Rich5252/Arduino_ESP32_AD9851_ssb_signal_generator/Design data/SSB_Exciter_G4AHN.png

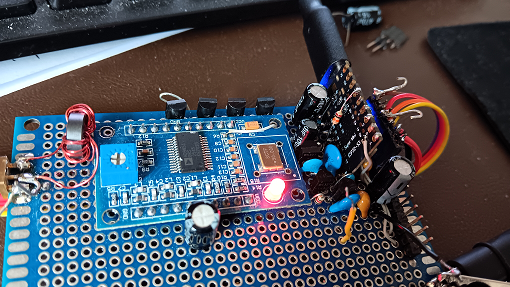
Design data/SSB_Exciter_G4AHN.png
