Rich5252/Arduino_ESP32_AD9851_ssb_signal_generator/Design data/timing_architecture.html

ESP32-S3 · Polar EER SSB Exciter · Firmware Reference

# How the two cores divide real-time work

gptimer drives a 64 kHz fast-tick interrupt on Core 1 that wakes dsp_task on Core 0 for every sample. Only one wake in four does the real DSP/RF work — that's the 16 kHz sample rate, Fs. Everything else on Core 1 (the ADC, loop(), serial, diagnostics) exists to stay out of that interrupt's way.

Every gray arrow is FreeRTOS/driver plumbing; the one in coral is the single hop that actually crosses cores — vTaskNotifyGiveFromISR(), fired from Core 1's gptimer ISR 64,000 times a second to wake dsp_task on Core 0. Everything else Core 1 does (ADC, serial, diagnostics) exists to avoid delaying that one interrupt. The two green badges mark the fixes confirmed on real hardware this session.

## Key rates & periods

Signal / event | Rate | Period | Note
C1→C0gptimer fast tick | 64 kHz | 15.625 µs | wakes dsp_task every firing; only 1 of 4 does full work
C0DSP full tick (Fs) | 16 kHz | 62.5 µs | SAMPLE_RATE_HZ — the real sample rate of the signal chain
C1ADC conversion | 80 kHz | 12.5 µs | free-running always, regardless of audio source mode
C1ADC callback (conv_done) | 5 kHz | 200 µs | 16-sample frames · ADC_CONT_FRAME_SAMPLES
C1loop() cycle | ~100 Hz | ~10 ms | delay(10)-dominated — ~98% of the cycle
C1diagnostics status line | ~22 Hz | 45 ms | envelope / freq_dev / dac_code, one line
C1diagnostics full block | ~1 Hz | ~1000 ms | [timing]/[adc]/[dsp]/[core1] — now per-line TX-guarded

ESP32-S3 · ssb_mic_test firmware · timing checkpoint as of this session cross-core hop confirmed fix
