Rich5252/Arduino_ESP32_AD9851_ssb_signal_generator/Design data/adc_filter_response_2026-09-29.png

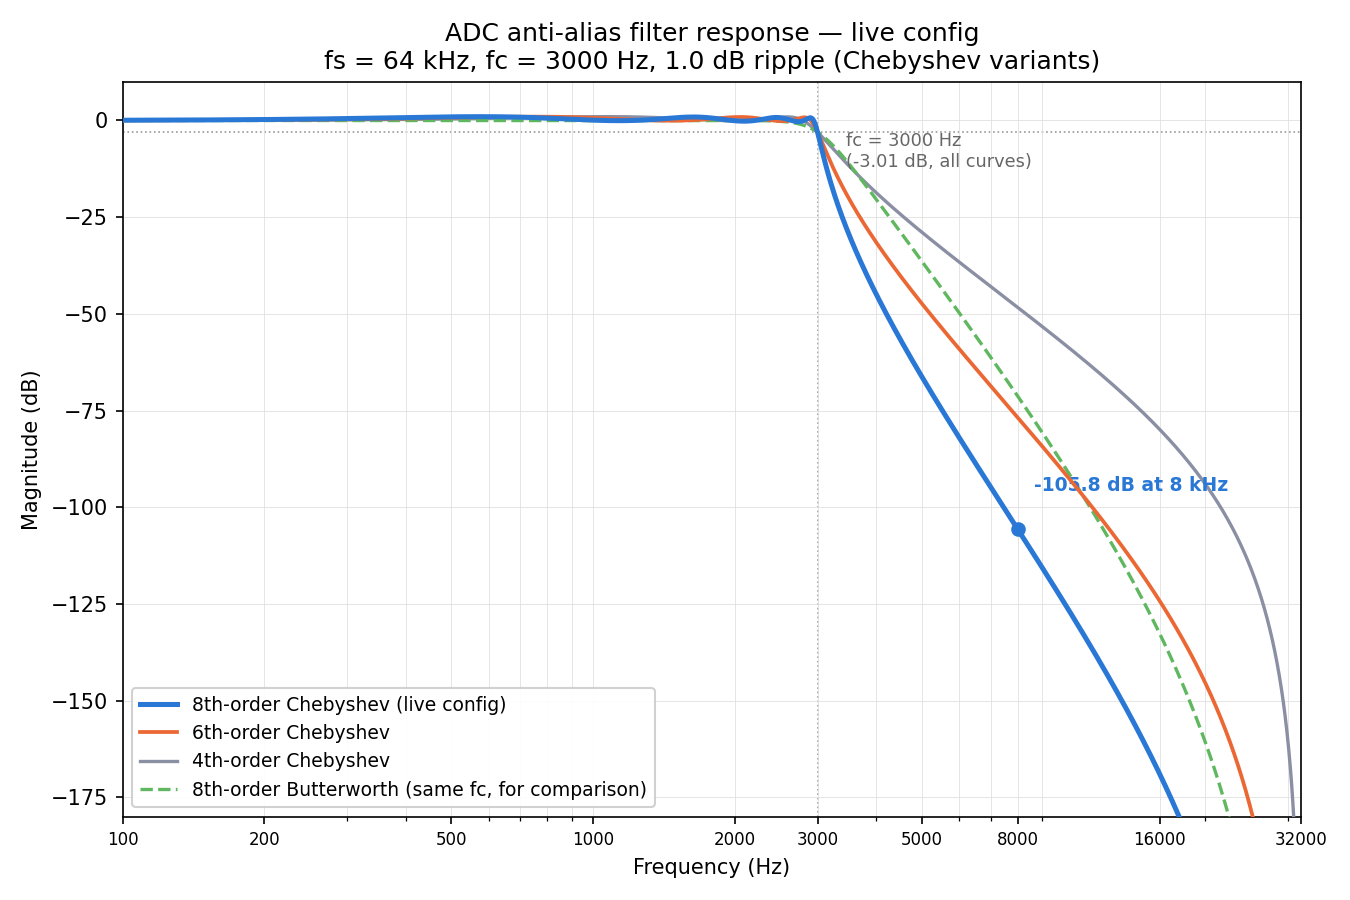
Design data/adc_filter_response_2026-09-29.png
