Rich5252/Arduino_ESP32_AD9851_ssb_signal_generator/Design data/PWM reconstruction Filter Circuit.png

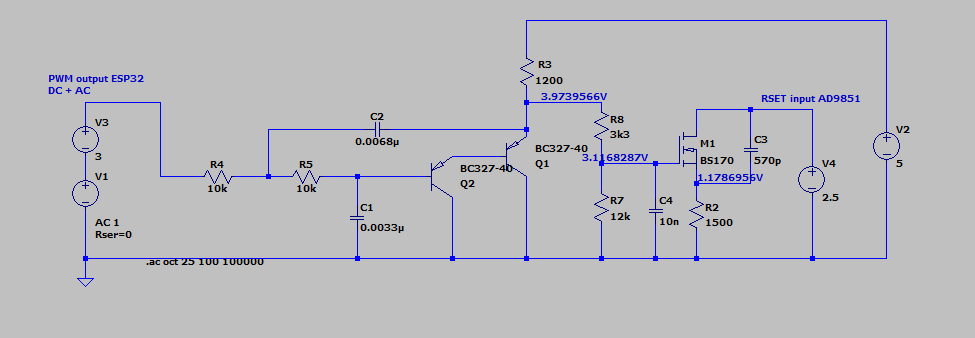
Design data/PWM reconstruction Filter Circuit.png
