Rich5252/Arduino_ESP32_AD9851_ssb_signal_generator/ssb_mic_test.ino

/**
 * DAC version 1
 * ssb_mic_test.ino
 *
 * Arduino-IDE test bed for the SSB mic/DSP pipeline, refactored from the
 * ESP-IDF main.c worked example. AD9851/DDS code is stubbed out entirely
 * (behind AD9851_ATTACHED) - this sketch exercises: mic ADC -> ssb_dsp ->
 * {freq_dev_hz, envelope} -> MCP4725 DAC output (RSET modulation), on two
 * FreeRTOS tasks:
 *
 *   dsp_task  (Core 0, high priority) - timer-notified, does the ADC read,
 *             DSP, and (when attached) the AD9851 SPI write. Never blocks
 *             on the DAC - it drops the computed envelope into a 1-deep
 *             "latest value wins" queue and moves straight on. (Briefly
 *             tried on Core 1 instead during the Fs jitter hunt - see
 *             setup()'s "TRIED, REVERTED" note - real hardware starved
 *             Serial entirely, reverted.)
 *   dac_task  (Core 1, lower priority) - blocks waiting for a new envelope
 *             value, then does the MCP4725 I2C fast-write (~70us at
 *             400kHz - far too slow to share a task with the phase-
 *             critical AD9851 update without risking it). At the current
 *             SAMPLE_RATE_HZ this comfortably fits within one sample
 *             period. If you ever raise the sample rate materially,
 *             revisit this - the I2C write doesn't scale down with a
 *             faster sample clock, and an SPI DAC (e.g. MCP4921) would be
 *             the fix at that point.
 *
 * Why a DAC instead of PWM+RC filter, MCP4725 pinout, ADC design history,
 * the group-delay-equalizer derivation, etc: see the module headers below
 * (envelope_output.h, adc_capture.h, envelope_gdeq.h, relative_delay.h) -
 * this file used to carry all of that inline, but at ~1900 lines with
 * everything in one place it was getting hard to navigate. It's now split
 * into one module per concern, each owning its own state behind a small
 * function-based interface (never raw `extern`-shared globals) so nothing
 * outside a module can get at its internals except through that
 * interface:
 *
 *   config.h           - shared compile-time constants (#defines only)
 *   settings.h          - audio_source_t, PersistentSettings, presets (unchanged)
 *   dsp_state.h/.cpp    - the ssb_dsp handle, sideband, audio source, gain cache
 *   adc_capture.h/.cpp  - adc_continuous DMA setup, ISR FIFO, biquad LPF
 *   test_signals.h/.cpp - two-tone/single-tone/ENVSTEP/FMTEST/AMTEST generators
 *   envelope_gdeq.h/.cpp- the envelope-path group-delay all-pass equalizer
 *   relative_delay.h/.cpp - phase/envelope fractional relative-timing line
 *   carrier_output.h/.cpp - AD9851 init + per-tick frequency update
 *   envelope_output.h/.cpp - PWM (RSET) + MCP4725 DAC + dac_task
 *   diagnostics.h/.cpp  - dsp_task timing stats + periodic status prints
 *   serial_commands.h/.cpp - the single-character serial command handler
 *
 * What's left here is genuinely top-level orchestration only: the sample
 * timer ISR, dsp_task's per-tick call sequence, setup(), and loop().
 * Nothing about the real-time behavior changed in this split - every
 * function that used to run inline in dsp_task is now a small IRAM_ATTR
 * function in its owning module, called in exactly the same order.
 *
 * NOT COMPILER-VERIFIED: this refactor was done by careful manual review
 * (no ESP32/Arduino toolchain available in the environment it was written
 * in) - run an Arduino IDE compile pass before flashing to hardware.
 *
 * Completely standalone - doesn't touch or depend on TXlink at all yet.
 * Drop this .ino into a sketch folder of the same name, next to all the
 * other .c/.cpp/.h files listed above.
 *
 * WIRING:
 *  - Mic preamp -> GPIO6 (ADC1 channel 5 on ESP32-S3).
 *  - MCP4725 SDA -> MCP4725_SDA_GPIO, SCL -> MCP4725_SCL_GPIO. Needs
 *    external ~4.7k pull-ups on both lines for reliable 400kHz operation -
 *    the ESP32's internal pull-ups are too weak on their own.
 *  - MCP4725 I2C address 0x61 (A0 pin tied high).
 *  - MCP4725 VOUT feeds your RSET modulation circuit.
 *  - PWM comparison output (RSET_MOD_LEDC_GPIO) -> RC filter -> scope,
 *    for side-by-side comparison against the DAC output only.
 *
 * What to check once the preamp and DAC are wired up:
 *  - Serial monitor (921600): throttled envelope/freq-dev/DAC-code
 *    summary, printed from loop() on Core 1 at low priority so it can
 *    never perturb either real-time task.
 *  - Scope on the MCP4725's VOUT pin: should track your voice envelope
 *    directly, no switching ripple to look for at all.
 *  - TWOTONE_TEST_MODE (config.h) bypasses the mic with a synthesized
 *    signal - a zero-hardware smoke test of the DSP chain.
 *
 * When the AD9851 board arrives: flip AD9851_ATTACHED to 1 (config.h) and
 * fill in ad9851_init()/ad9851_set_frequency() calls - the DSP/task/
 * timer/DAC structure here doesn't need to change either way.
 *
 * AUDIO_FX_ENABLED (config.h) turns on an optional pre-Hilbert
 * conditioning stage inside ssb_dsp itself (HPF + presence peak +
 * compressor, see ssb_dsp.h). Runs on plain mult/add per sample - no
 * measurable timing impact expected, but re-check the TIMING_DEBUG_GPIO
 * scope trace after enabling to confirm rather than assume.
 *
 * ADC: uses adc_continuous (DMA), not adc_oneshot - see adc_capture.h for
 * the full history of why.
 */

#include <math.h>
#include <string.h>
#include "freertos/FreeRTOS.h"
#include "freertos/task.h"
#include "driver/gptimer.h"
#include "esp_attr.h"
#include "esp_log.h"
#include "esp_timer.h"
#include "esp_rom_sys.h"
#include "soc/gpio_struct.h"   // GPIO.out_w1ts/w1tc - see on_timer_alarm()'s Fs jitter hunt toggle
#include "soc/ledc_struct.h"   // LEDC.channel_group[].channel[] raw registers - see ISR_PWM_FIXED_TEST_ENABLED
                                // in config.h and on_timer_alarm()'s own comment: same "raw struct instead
                                // of the driver call" idiom as GPIO above, needed because ledc_set_duty()/
                                // ledc_update_duty() are NOT ISR-safe (general driver calls - see
                                // envelope_output_write_pwm()'s own comment for why that matters here).

// Shared compile-time configuration - must come before any other project
// header (gates #if blocks in several of them, e.g. PWM_COMPARISON_ENABLED
// must be known before envelope_output.cpp includes "driver/ledc.h").
#include "config.h"

// Pre-defined settings tables (audio_source_t, PersistentSettings, presets)
#include "settings.h"

#include "ssb_dsp.h"

#include "dsp_state.h"
#include "adc_capture.h"
#include "test_signals.h"
#include "envelope_gdeq.h"
#include "envelope_ampeq.h"
#include "envelope_alc.h"
#include "envelope_softlimit.h"
#include "envelope_predistort.h"
#include "envelope_floor.h"
#if AD9851_ATTACHED
#include "relative_delay.h"
#include "carrier_output.h"
#endif
#include "envelope_output.h"
#include "envelope_interp.h"
#include "diagnostics.h"
#include "serial_commands.h"

// (No TAG/ESP_LOG here - everything in this file uses Serial.printf so it's
// visible regardless of the IDE's Core Debug Level setting. ssb_dsp.c has
// its own separate TAG for its internal ESP_LOG calls.)

// 2026-09-29: this used to be a hard #error requiring ENVELOPE_INTERP_
// FACTOR==1 - see config.h's AD9851_ISR_WRITE_ENABLED comment for the
// original reasoning (the ISR couldn't tell which firing was a true
// full-tick boundary, so it would have committed stale data on 3-of-4
// firings at FACTOR>1). Lifted: on_timer_alarm() below now tracks its own
// local full-tick counter (s_isr_full_tick_counter) and gates both the
// AD9851 write and the notify-to-dsp_task on it, so this is correct at any
// FACTOR - at FACTOR==1 the counter wraps every firing and behavior is
// bit-for-bit identical to before this change. See moving_forward_notes.md's
// 2026-09-29 entry (the one after "user hit the ENVELOPE_INTERP_FACTOR==1
// #error guard") for the full before/after reasoning, and on_timer_alarm()'s
// own comment for the mechanism. Envelope/PWM interpolation itself is
// NOT part of this fix - it stays exactly as coarse as FACTOR==1 gave it
// (held between full ticks) until envelope_interp's own ISR-safe,
// integer-only fast-tick write is built - this only unblocks AD9851 timing
// and the wake-rate cost, deliberately staged separately.

static TaskHandle_t s_dsp_task;

#if AD9851_ATTACHED && TX_WRITE_RESYNC_ENABLED
// 2026-09-19: write-time-jitter fix, folded in from minimal_fs_test_step5_
// resync/step6_isr_write after real-hardware bench confirmation - see
// config.h's TX_WRITE_RESYNC_ENABLED/AD9851_ISR_WRITE_ENABLED comment and
// null_bias_investigation.md/moving_forward_notes.md's 2026-09-19 entries
// for the full story. This tick's already-delay-line-adjusted
// envelope/freq_dev result is buffered here instead of written
// immediately - it gets written as the very FIRST action of the NEXT
// tick, in dsp_task's main loop, before that tick's own DSP work starts.
//
// volatile: with AD9851_ISR_WRITE_ENABLED, s_pending_tx_freq is read from
// the gptimer ISR on Core 1 while dsp_task (Core 0) writes it - a genuine
// cross-core shared variable. Aligned 32-bit reads/writes are atomic on
// this target (same reasoning already established elsewhere in this
// project, e.g. AD9851.c's own busy_us high-water-mark fields), so no lock
// is needed, but volatile IS needed to stop either side caching a stale
// value in a register across the ISR/task boundary. s_pending_freq_dev_hz/
// s_pending_envelope are only ever touched from dsp_task (never from the
// ISR) but kept volatile too for consistency with the one field that
// genuinely needs it.
static volatile float s_pending_freq_dev_hz = 0.0f;   // only used when !AD9851_ISR_WRITE_ENABLED (task-side write)
static volatile float s_pending_envelope = 0.0f;
static volatile uint32_t s_pending_tx_freq = 0;        // already-integer - see carrier_output_compute_tx_freq()
static volatile bool s_pending_valid = false;          // guards the very first tick (nothing buffered yet)

#if AD9851_ISR_WRITE_ENABLED
// Staging-race diagnostic - directly modeled on the second of the two
// suspected mechanisms in the SDM ISR-commit postmortem
// (group_delay_fit_notes.md, 2026-09-08 "REVERTED" entry): if dsp_task is
// ever still working when the NEXT alarm fires, the ISR would commit a
// value staged MORE than one tick ago - stale by more than the clean,
// constant one-tick offset this design assumes. s_stage_seq increments
// every time dsp_task finishes staging a fresh value (below);
// s_isr_last_seen_seq (ISR-context-only - single reader/writer, no lock
// needed) is what the ISR last saw. A match on the ISR's next firing means
// dsp_task hasn't staged anything new since the last commit. Measured, not
// just hoped against - see diagnostics.cpp's print_timing_and_adc_block()
// for where this gets reported ("[timing]   AD9851 ISR write:
// stale_commits=...").
static volatile uint32_t s_stage_seq = 0;
static uint32_t s_isr_last_seen_seq = 0;
static volatile uint32_t s_stale_commit_count = 0;
#endif
#endif

static bool IRAM_ATTR on_timer_alarm(gptimer_handle_t timer, const gptimer_alarm_event_data_t *edata, void *user_ctx)
{
#if TIMING_DEBUG_ENABLED
    // Fs jitter hunt - see config.h's TIMING_DEBUG_GPIO_ISR comment. Raw
    // register toggle (not digitalWrite) - real ISR context, this MUST
    // stay IRAM-safe with zero risk of calling into a non-IRAM-resident
    // function. GPIO.out_w1ts/w1tc is a direct memory-mapped register
    // write, no function call at all - the standard idiom for exactly
    // this.
    //
    // Falling edge here = true ISR entry instant, zero added latency -
    // trigger/measure jitter off THIS edge, not the rising one. The
    // matching out_w1ts sits AFTER vTaskNotifyGiveFromISR() below instead
    // of immediately after this line, so the LOW pulse width becomes
    // "however long the notify call itself took" - free width for a
    // 100MHz scope to resolve (using real work's own duration, not an
    // added delay), instead of two back-to-back register writes that are
    // over almost as soon as they start.
    GPIO_FAST_CLR(TIMING_DEBUG_GPIO_ISR);
#endif

#if ISR_PWM_FIXED_TEST_ENABLED
    // TEMPORARY DIAGNOSTIC (see config.h's ISR_PWM_FIXED_TEST_ENABLED
    // comment for the full reasoning/warnings - this overrides real
    // envelope output with a constant while active). Deliberately
    // UNCONDITIONAL: runs on EVERY fast tick regardless of is_full_tick,
    // AD9851_ISR_WRITE_ENABLED, or anything else this ISR does, because
    // the point is to test the worst-case "a register write on every
    // single fast tick" timing cost in isolation, as the precursor step
    // before the real integer-only envelope fast-tick write is built.
    //
    // Raw peripheral struct write, NOT ledc_set_duty()/ledc_update_duty()
    // - those are general ESP-IDF driver calls, confirmed NOT ISR-safe
    // (see envelope_output_write_pwm()'s own comment and envelope_
    // interp.h's v1 history: a general driver call from true ISR context
    // is exactly what rebooted v1). Same "raw struct instead of the
    // driver call" idiom as GPIO.out_w1ts/w1tc above, applied to LEDC via
    // soc/ledc_struct.h.
    //
    // UNVERIFIED FIELD NAMES: LEDC.channel_group[...].channel[...].duty.
    // duty, .conf1.duty_start, and .conf0.low_speed_update are from
    // general ESP32/S2/S3 LEDC peripheral knowledge, NOT checked against
    // this project's exact installed ESP-IDF/Arduino-ESP32 SDK version
    // (no local toolchain available to verify this in the environment
    // this was written in). The "<< 4" mirrors the LEDC hardware duty
    // register's known 4 fractional bits below the integer duty
    // resolution on this SoC family - also unverified against this exact
    // SDK for this exact duty_resolution setting. If this fails to
    // compile, the compiler error will name the exact field that's wrong
    // for this SDK version - treat that as a diagnostic pointing at the
    // fix, not a dead end.
    //
    // 2026-09-29 CORRECTION, first-bench-result-driven: the initial
    // version of this block only set duty.duty + conf1.duty_start, and
    // real hardware showed the pin alternating between the fixed test
    // value ("constant", ~6ms stretches) and the REAL modulated envelope
    // ("old waveform", ~4.5ms stretches) - roughly two orders of
    // magnitude slower than either the 15.6us fast-tick or 62.5us
    // full-tick period, so it isn't explained by a simple per-tick race
    // between this write and dsp_task's own envelope_output_write_pwm().
    // Leading hypothesis: on ESP32-S2/S3, EVERY LEDC channel is a
    // "low-speed" channel (these chips have no high-speed LEDC mode at
    // all - SOC_LEDC_SUPPORT_HS_MODE=0), and low-speed channels need a
    // SECOND, separate commit trigger beyond duty_start before a new duty
    // value actually latches into the active register: conf0.
    // low_speed_update=1. This matches the ESP-IDF driver's own
    // ledc_update_duty() internals as best recalled (duty_start, THEN
    // low_speed_update) - without it, a raw duty_start write may sit
    // pending/ineffective, so what actually landed on the pin was
    // whatever the LAST successfully-committed write was (which could be
    // this write on a lucky cycle, or leftover from dsp_task's own -
    // correctly formed, driver-based - write), rather than genuinely
    // alternating envelope content driving it. Added the missing trigger
    // below - STILL UNVERIFIED against this exact SDK, same caveat as
    // the other two field names above. If the pin now holds the fixed
    // test value SOLIDLY (no more "old waveform" windows) once flashed,
    // that's good evidence this was the missing piece; if it's still
    // intermittent, that theory is wrong and something else (ISR not
    // actually running steadily at 64kHz for multi-ms stretches, most
    // likely candidate: some other interrupt-disabling activity
    // elsewhere in the system) needs to be hunted instead.
    //
    // 2026-09-30 CORRECTION: removed the "<< 4" this line originally had.
    // envelope_output_isr_fasttick_step() (envelope_output.cpp) used the
    // identical assumption ("hardware wants the native duty count
    // pre-shifted left by 4") and real hardware proved it wrong - with
    // ENVELOPE_ISR_INTERP_ENABLED's real envelope write, normal (non-
    // duty-override) content pinned the PWM "stuck at max env level" for
    // anything above ~1/16 of full scale, exactly the saturation you'd
    // expect writing a >1023 value into a comparator that only counts
    // 0..1023 for this configured resolution/rate. ISR_PWM_FIXED_TEST_DUTY
    // is documented as a plain 0..1023 native value (see config.h) - this
    // line was writing 16x that into the register the whole time this
    // diagnostic has existed. Its own bench results ("constant level,
    // running OK") only ever checked TIMING/stability, never the absolute
    // duty percentage against a known reference, so this went unnoticed.
    // Fixed here for consistency/correctness even though this flag is
    // currently 0 (dormant) - see moving_forward_notes.md's matching
    // 2026-09-30 entry for the full story and the envelope_output.cpp fix
    // this mirrors.
    LEDC.channel_group[LEDC_LOW_SPEED_MODE].channel[RSET_MOD_LEDC_CH].duty.duty = ((uint32_t)ISR_PWM_FIXED_TEST_DUTY) << 4;   // 2026-09-30: << 4 RESTORED - duty.duty has 4 fractional bits, see envelope_output.cpp's SECOND CORRECTION
    LEDC.channel_group[LEDC_LOW_SPEED_MODE].channel[RSET_MOD_LEDC_CH].conf1.duty_start = 1;
    LEDC.channel_group[LEDC_LOW_SPEED_MODE].channel[RSET_MOD_LEDC_CH].conf0.low_speed_update = 1;
#endif

    // 2026-09-29: v6 real envelope fast-tick write (ENVELOPE_ISR_INTERP_
    // ENABLED, envelope_interp.h) - the successor to the
    // ISR_PWM_FIXED_TEST_ENABLED probe right above, built once that probe
    // confirmed a raw per-fast-tick LEDC write fits the timing budget.
    // Called UNCONDITIONALLY, no #if here by design: envelope_output_isr_
    // fasttick_step() (envelope_output.cpp) compiles to a plain no-op
    // when ENVELOPE_ISR_INTERP_ENABLED is 0, so this call site never needs
    // its own guard, matching envelope_output_write_sdm()'s own always-
    // callable-no-op-when-disabled convention elsewhere in this codebase.
    // Applies whatever per-tick duty step dsp_task last staged (envelope_
    // output_isr_stage_step(), called from envelope_interp_on_full_tick()
    // on full ticks only) and writes the LEDC duty register directly -
    // integer-only, IRAM_ATTR, no driver calls - see that function's own
    // comment (envelope_output.h) for the fixed-point design. Runs on
    // EVERY fast tick, same reasoning as ISR_PWM_FIXED_TEST_ENABLED's own
    // write above: the actual envelope interpolation only means anything
    // if it updates faster than SAMPLE_RATE_HZ.
    envelope_output_isr_fasttick_step();

#if AD9851_ATTACHED && AD9851_ISR_WRITE_ENABLED
    // 2026-09-29: local full-tick gate, added so this works correctly at
    // ENVELOPE_INTERP_FACTOR>1, not just FACTOR==1 (see this file's own
    // #error-removal comment near the top and config.h's AD9851_ISR_WRITE_
    // ENABLED comment for the full history). Plain integer counter,
    // increment/compare/wrap only - deliberately the exact same shape as
    // ENVELOPE_INTERP_USE_HW_FADE's own counter further down, which already
    // proved this pattern is safe in true ISR context on this chip (no
    // float, no driver call). At FACTOR==1 this is a no-op: the counter
    // wraps every single firing, so is_full_tick is unconditionally true
    // and everything below behaves bit-for-bit as it did before this
    // change.
    //
    // NOT the same mechanism as ENVELOPE_INTERP_USE_HW_FADE, even though
    // both end up wanting "only touch things on a true full-tick boundary"
    // - that one is about the LEDC hardware fade engine for envelope
    // (found measurably worse on real hardware, disabled today); this one
    // is purely about AD9851 write timing and the notify-rate cost. Kept
    // as two independent counters/mechanisms rather than merged, so a
    // future revert of one can't accidentally disturb the other.
    //
    // CHIRP-mode caveat (same one ENVELOPE_INTERP_USE_HW_FADE's own
    // comment documents, for the identical reason): CHIRP mode's fast
    // per-tick waveform generation only runs when dsp_task is actually
    // woken. Gating the notify to full-tick boundaries below means CHIRP
    // mode is capped to SAMPLE_RATE_HZ (16kHz) even when
    // ENVELOPE_INTERP_FACTOR>1 - it can't reach its intended 20kHz sweep
    // range under this flag. Not fixed here, just flagged so it isn't
    // rediscovered blind.
    static uint32_t s_isr_full_tick_counter = 0;
    s_isr_full_tick_counter++;
    bool is_full_tick = false;
    if (s_isr_full_tick_counter >= ENVELOPE_INTERP_FACTOR) {
        s_isr_full_tick_counter = 0;
        is_full_tick = true;
    }

    // 2026-09-19: write-time-jitter fix, folded in from minimal_fs_test_
    // step6_isr_write after real-hardware bench confirmation - see
    // config.h's AD9851_ISR_WRITE_ENABLED comment and
    // null_bias_investigation.md/moving_forward_notes.md's 2026-09-19
    // entries for the full story. Writes LAST tick's already-computed,
    // already-delay-line-adjusted frequency here, as close to this ISR's
    // own falling edge above (the true, hardware-clocked Fs reference -
    // confirmed rock-solid on a scope, unlike everything downstream of it)
    // as this system can get - removes the cross-core ISR-to-task
    // hand-off latency that dsp_task's own write used to add on top of its
    // own DSP execution time.
    //
    // Uses carrier_output_set_freq_dev_raw() (pure integer register pokes
    // via ad9851_set_frequency() - confirmed by reading AD9851.c directly:
    // no float, no ESP-IDF driver call, no FreeRTOS API, no allocation, no
    // locks) on the ALREADY-CONVERTED s_pending_tx_freq - NEVER the
    // float-taking carrier_output_set_freq_dev(). This distinction is
    // load-bearing, not stylistic: this exact fix's own bench validation
    // panicked (Guru Meditation Error, Coprocessor exception, EXCCAUSE
    // 0x4) the first time it called the float-taking function directly
    // from an ISR - see carrier_output.h's comment on these two functions.
    //
    // Envelope/PWM is deliberately NOT written here at all - it stays
    // task-side (dsp_task's own resync block, below), per the SDM
    // ISR-commit precedent right below this comment: a stage-in-task/
    // commit-from-ISR split was already tried for the SDM envelope-output
    // leg and measured WORSE, not better, on real hardware. AD9851's
    // bit-bang transport is a fundamentally different, safer case (no
    // driver call, no flash-residency ambiguity) than LEDC/SDM, which is
    // why only this leg moved into the ISR.
    //
    // 2026-09-29: now gated on is_full_tick (see above) - only commit on a
    // true full-tick boundary. On the ENVELOPE_INTERP_FACTOR-1 fast ticks
    // in between, do nothing: the AD9851 simply holds its last-written
    // frequency, which is the correct behavior (the phase/frequency path
    // was never meant to be interpolated the way envelope is).
#if ISR_NOTIFY_BEFORE_AD9851_ENABLED
    // 2026-09-30: see config.h's ISR_NOTIFY_BEFORE_AD9851_ENABLED comment.
    // The value to write is SNAPSHOTTED here (before dsp_task is woken) and
    // the actual bit-bang happens after vTaskNotifyGiveFromISR() below. The
    // snapshot matters: once dsp_task is running concurrently on Core 0 it
    // will eventually restage s_pending_tx_freq at the end of its tick, and
    // the write must use THIS tick's value regardless of how quickly that
    // happens. The staleness check and s_isr_last_seen_seq update stay here,
    // exactly where they were, so stale_commits keeps its meaning.
    bool     do_ad9851_write        = false;
    uint32_t ad9851_freq_snapshot   = 0;
#endif
    if (is_full_tick && s_pending_valid) {
        if (s_stage_seq == s_isr_last_seen_seq) {
            // Staging-race: dsp_task hasn't staged a fresh value since our
            // last commit - this write is about to reuse a value more
            // than one tick old. Still commit it (skipping would leave
            // the AD9851 holding an even-more-stale frequency) but count
            // it - see s_stale_commit_count's own declaration comment.
            s_stale_commit_count++;
        }
        s_isr_last_seen_seq = s_stage_seq;
#if ISR_NOTIFY_BEFORE_AD9851_ENABLED
        ad9851_freq_snapshot = s_pending_tx_freq;
        do_ad9851_write = true;
#else
        carrier_output_set_freq_dev_raw(s_pending_tx_freq);
#endif
    }
#endif

    // 2026-09-08: a direct-from-ISR SDM commit briefly lived here
    // (envelope_output_commit_sdm_from_isr()), trying to remove dsp_task's
    // own cross-core wake/scheduling latency from the SDM write's timing.
    // REVERTED - real hardware measured WORSE with it (another ~1dB of IMD
    // gone, close-in jitter still present or worse), not better. Two
    // suspected reasons: sdm_channel_set_pulse_density()'s IRAM residency
    // is gated by a Kconfig option (CONFIG_SDM_CTRL_FUNC_IN_IRAM) this
    // project can't confirm is set in the installed Arduino-ESP32 core -
    // if not, that call was FLASH-resident code running inside this ISR,
    // risking exactly the cache-line-stall class of problem dac_task's I2C
    // activity already caused once before (see this task's own IRAM_ATTR
    // comment below); and/or dsp_task occasionally staging its value too
    // late relative to the NEXT tick's alarm (see the elapsed_fast_ticks/
    // coalescing comment further down for why that's a real possibility on
    // this hardware), turning the intended fixed one-tick delay into an
    // occasional larger, irregular one. Full writeup: envelope_output.h's
    // own comment on envelope_output_write_sdm(), and group_delay_fit_
    // notes.md's matching entry. SDM's actual hardware write is back to
    // being a plain synchronous call from dsp_task (envelope_interp.cpp),
    // same as the PWM leg.
    BaseType_t high_task_woken = pdFALSE;
#if AD9851_ATTACHED && AD9851_ISR_WRITE_ENABLED
    // 2026-09-29: reuses is_full_tick computed above (AD9851_ISR_WRITE_
    // ENABLED's own full-tick counter) - dsp_task is now woken only on
    // true full-tick boundaries, same property ENVELOPE_INTERP_USE_HW_FADE
    // provides independently below for its own reason. This is also the
    // fix for the wake-rate "burble" confirmed on real hardware 2026-09-07
    // (waking dsp_task 64,000 times/sec, even doing nothing on most of
    // them, was itself costly) - see dsp_task's own is_full_tick check
    // ("ENVELOPE_INTERP_USE_HW_FADE || (AD9851_ATTACHED &&
    // AD9851_ISR_WRITE_ENABLED)") for the task-side half of this.
    if (is_full_tick) {
        vTaskNotifyGiveFromISR(s_dsp_task, &high_task_woken);
    }
#elif ENVELOPE_INTERP_USE_HW_FADE
    // 2026-09-08: see envelope_interp.h's ENVELOPE_INTERP_USE_HW_FADE
    // comment for the full reasoning. The gptimer hardware still fires at
    // its usual ENVELOPE_INTERP_FACTOR x SAMPLE_RATE_HZ (64kHz) rate,
    // unchanged - only whether THIS ISR bothers to cross-core-notify
    // dsp_task on any given alarm changes. Plain integer counter, no
    // float, no driver calls beyond the same vTaskNotifyGiveFromISR()
    // already proven ISR-safe here - deliberately as close to v1/v2's
    // ISR-safety boundary as this file gets, on purpose, since those two
    // generations crashed specifically from float math and LEDC driver
    // calls in ISR context, neither of which happens here.
    static uint32_t s_isr_fast_tick_counter = 0;
    s_isr_fast_tick_counter++;
    if (s_isr_fast_tick_counter >= ENVELOPE_INTERP_FACTOR) {
        s_isr_fast_tick_counter = 0;
        vTaskNotifyGiveFromISR(s_dsp_task, &high_task_woken);
    }
#else
    vTaskNotifyGiveFromISR(s_dsp_task, &high_task_woken);
#endif
#if AD9851_ATTACHED && AD9851_ISR_WRITE_ENABLED && ISR_NOTIFY_BEFORE_AD9851_ENABLED
    // 2026-09-30: deferred AD9851 write - see config.h's
    // ISR_NOTIFY_BEFORE_AD9851_ENABLED comment. dsp_task has already been
    // woken above, so it runs in parallel with this bit-bang instead of
    // waiting for it. Same integer-only, ISR-safe call as before, same value
    // (snapshotted above).
    if (do_ad9851_write) {
        carrier_output_set_freq_dev_raw(ad9851_freq_snapshot);
    }
#endif
#if TIMING_DEBUG_ENABLED
    // NOTE (2026-09-30): with ISR_NOTIFY_BEFORE_AD9851_ENABLED the low pulse
    // now ends after the AD9851 write (it used to end just after the notify),
    // so its width is still "whole full-tick ISR body" but the notify edge is
    // no longer visible inside it.
    GPIO_FAST_SET(TIMING_DEBUG_GPIO_ISR);   // rising edge = ISR body done (was: notify call done), about to return
#endif
    return high_task_woken == pdTRUE;
}

// IRAM_ATTR - keeps this task's code in internal RAM rather than flash,
// so it's immune to cache-line stalls caused by Core 1 activity (dac_task's
// I2C driver work) touching flash. Confirmed by disabling dac_task and
// seeing timing clean up - this is the structural fix rather than just
// working around it by leaving dac_task off. Every module function called
// from here is itself IRAM_ATTR for the same reason - see each module's
// header.
static void IRAM_ATTR dsp_task(void* arg)
{
    // Simple DC-blocking single-pole high-pass state (mic path only).
    // dc_alpha is derived from DC_BLOCK_TIME_CONSTANT_S (config.h) rather
    // than a hardcoded per-sample constant, so the real-world cutoff stays
    // the same regardless of SAMPLE_RATE_HZ.
    float dc_estimate = 0.0f;
    const float dc_alpha = expf(-1.0f / (SAMPLE_RATE_HZ * DC_BLOCK_TIME_CONSTANT_S));

#if AD9851_ATTACHED
    // One-time throwaway SPI transfer, BEFORE the real-time loop below
    // starts - pays a one-time cost here instead of on the loop's first
    // live tick. Confirmed via [timing]: a fresh boot showed a single
    // ~264-265us spi_us spike (reproducible across independent reboots -
    // a deterministic cost, not a scheduling fluke) on exactly the first
    // dsp_task tick, causing exactly one overrun/late tick, never
    // recurring afterward. Best explanation: carrier_output_init() (in
    // setup(), which runs on a different core than dsp_task - see this
    // function's own IRAM_ATTR comment above) already calls
    // ad9851_set_frequency() once, but that only warms ITS core's
    // i-cache; this task's own IRAM_ATTR only covers this project's own
    // code, not the ESP-IDF spi_master driver internals underneath
    // spi_device_polling_transmit() - those still live in flash unless
    // CONFIG_SPI_MASTER_IN_IRAM is set, so Core 0 pays its own first-call
    // cache-fill cost regardless of what Core 1 already ran. Harmless in
    // practice (no one is transmitting through this before dsp_task's
    // loop even starts), but free to eliminate here rather than on a
    // live sample.
    carrier_output_set_freq_dev(0.0f);
#endif

    // Fast-tick counter for envelope_interp's v4 design (see envelope_
    // interp.h): the sample gptimer itself now runs at ENVELOPE_INTERP_
    // FACTOR x SAMPLE_RATE_HZ, but the full DSP pipeline below still only
    // runs on 1 in ENVELOPE_INTERP_FACTOR of those wakes ("full" ticks,
    // still true SAMPLE_RATE_HZ) - the rest just walk envelope_interp's
    // linear ramp and return immediately. dsp_task-private, single-
    // threaded - see init_sample_timer() for the timer side of this.
    uint32_t fast_tick_count = 0;
    // Which ENVELOPE_INTERP_FACTOR-sized "group" of fast ticks the last
    // full tick belonged to (fast_tick_count / ENVELOPE_INTERP_FACTOR) -
    // see the is_full_tick check below for why this replaced a plain
    // "% ENVELOPE_INTERP_FACTOR == 0" check.
    uint32_t last_full_group = 0;

    while (1) {
        // Block until the timer ISR notifies us - this sets our fast tick
        // rate (ENVELOPE_INTERP_FACTOR x SAMPLE_RATE_HZ - see above).
        //
        // ulTaskNotifyTake(pdTRUE, ...) - xClearCountOnExit=pdTRUE - CLEARS
        // FreeRTOS's notification count to 0 on every take, but its RETURN
        // VALUE is how many times the ISR actually gave (i.e. how many
        // real fast-tick periods have elapsed) since our last take - if
        // dsp_task is ever even briefly late getting back here (a cache
        // stall, a moment of contention, anything), two or more real
        // 15.6us hardware periods can coalesce into a single wake. Bug
        // fix (found on real hardware: envelope timing was jittery, IMDs
        // shuffled, EVEN WITH 'I' fully disabled): the first cut of this
        // loop discarded that return value and did a bare fast_tick_
        // count++ per wake, which silently desyncs fast_tick_count from
        // the TRUE hardware period count the moment even one coalescing
        // event happens - after that, "full" ticks (where the real DSP
        // work and the real PWM write happen) start firing at the wrong,
        // irregular offsets relative to the true SAMPLE_RATE_HZ grid,
        // indefinitely, until another coalescing event randomly happens
        // to correct (or worsen) the drift. That's sample-clock jitter on
        // the DSP rate itself - explains both symptoms (irregular
        // envelope timing; IMDs moving both up and down, not uniformly,
        // which is what jitter does to a spurious floor). Fix: advance
        // fast_tick_count by the ACTUAL elapsed count, not by 1 - it then
        // always equals the true cumulative hardware period count since
        // boot, so long-run phase can never PERMANENTLY drift, no matter
        // how many wakes it took to get there.
        uint32_t elapsed_fast_ticks = ulTaskNotifyTake(pdTRUE, portMAX_DELAY);
        if (elapsed_fast_ticks < 1) {
            elapsed_fast_ticks = 1;   // shouldn't happen (portMAX_DELAY blocks until >=1), defensive only
        }
        fast_tick_count += elapsed_fast_ticks;

        // Bug fix on top of the above (found on real hardware: envelope
        // still "moving around" even after the fix above landed): a bare
        // "fast_tick_count % ENVELOPE_INTERP_FACTOR == 0" check assumes a
        // coalescing event always lands EXACTLY on a multiple of
        // ENVELOPE_INTERP_FACTOR. It doesn't have to - if a full tick's
        // own DSP processing occasionally takes long enough that MORE
        // than ENVELOPE_INTERP_FACTOR real hardware periods elapse before
        // getting back here, fast_tick_count can jump straight PAST the
        // next full-tick boundary (e.g. 3 -> 8, skipping 4 entirely) - a
        // plain modulo check then stays false for several more ticks
        // until the count next happens to land exactly on a multiple,
        // meaning that period's real DSP sample (ADC/Hilbert/atan2/AD9851/
        // the lot) is skipped outright, not just an interpolation cosmetic
        // step - and the NEXT full tick is delayed by however many extra
        // sub-periods it takes to re-land on a clean multiple, compounding
        // the original overrun instead of just absorbing it. Comparing
        // which ENVELOPE_INTERP_FACTOR-sized GROUP fast_tick_count falls
        // into, rather than its exact remainder, fixes this: any update
        // that crosses one or more group boundaries is recognized as a
        // full tick immediately, on the very next wake, however far past
        // the exact boundary the coalesced count landed - so a bad
        // overrun still costs the one sample it made unrecoverable, but
        // never cascades into delaying subsequent ones too.
#if ENVELOPE_INTERP_USE_HW_FADE || (AD9851_ATTACHED && AD9851_ISR_WRITE_ENABLED)
        // 2026-09-08 (ENVELOPE_INTERP_USE_HW_FADE), extended 2026-09-29 to
        // also cover AD9851_ISR_WRITE_ENABLED: under EITHER, on_timer_alarm()
        // (above) only ever notifies dsp_task on true full-tick
        // boundaries (1-in-ENVELOPE_INTERP_FACTOR real alarms) - every
        // wake IS a full tick, there's no separate "interp tick" wake
        // left to distinguish. The group-based math below assumes
        // fast_tick_count is counting 64kHz-rate fast ticks (one per
        // real alarm) and would silently divide the full-tick rate by
        // ENVELOPE_INTERP_FACTOR AGAIN if left active here - bypassed
        // entirely instead of trying to adapt it, since there's nothing
        // left for it to compute (fast_tick_count itself still accumulates
        // via elapsed_fast_ticks above, but nothing downstream reads it
        // once this branch is taken - harmless, just unused). CHIRP mode
        // is NOT compatible with either flag, for the same reason (see
        // envelope_interp.h's own comment and on_timer_alarm()'s
        // AD9851_ISR_WRITE_ENABLED comment) - don't combine.
        bool is_full_tick = true;
#else
        uint32_t fast_tick_group = fast_tick_count / ENVELOPE_INTERP_FACTOR;
        bool is_full_tick = (fast_tick_group != last_full_group);
        if (is_full_tick) {
            last_full_group = fast_tick_group;
        }
#endif

        // Sine-chirp test mode ('w', AUDIO_SRC_CHIRP) - intercepted here,
        // BEFORE the is_full_tick check below, so it runs on EVERY fast
        // tick (the full ENVELOPE_INTERP_FACTOR x SAMPLE_RATE_HZ = 64kHz
        // rate), not just the 1-in-ENVELOPE_INTERP_FACTOR full ticks the
        // rest of this loop uses. A 20kHz chirp needs more than
        // SAMPLE_RATE_HZ's own 8kHz Nyquist, so this mode can't reuse the
        // normal 16kHz full-tick pipeline the way ENVSTEP/FMTEST/AMTEST
        // do - it bypasses ADC/ssb_dsp_process_sample/envelope_floor/
        // relative_delay/AD9851/normal diagnostics, writing (almost)
        // straight to the PWM output and the reference GPIO instead. Raw
        // register writes for the reference pin (GPIO.out_w1ts/w1tc), not
        // digitalWrite - this runs at 64kHz, same real-time-sensitivity
        // reasoning as on_timer_alarm()'s own ISR-context register writes
        // (see config.h's TIMING_DEBUG_GPIO_ISR comment), even though this
        // call site is task, not ISR, context.
        //
        // "Almost" straight to the PWM output: the offset/scale (or
        // predistort) DC mapping is deliberately NOT skipped - see the
        // comment right before that call below for why, and 'u'/'j'/'i'/
        // 'k'/'D' in serial_commands.cpp for the knobs it wires in.
        // 2026-09-02: envelope_gdeq_process() (the 'g' group-delay
        // equalizer) is now wired in too - see its own comment below -
        // specifically so the TF analyzer can measure the analog
        // reconstruction filter's group delay WITH the digital
        // equalizer's correction applied, not just the raw filter, and
        // compare the two sweeps directly. 2026-09-03: envelope_ampeq_
        // process() (the 'a' magnitude equalizer) is wired in the same
        // way, for the same reason on the sweep's AMPLITUDE channel
        // instead. envelope_floor stays skipped: it's a hard near-zero
        // clamp aimed at squelching mic-path noise at silence, not
        // something a swept-tone TF measurement exercises or benefits
        // from measuring through.
        //
        // 2026-09-06, IMPORTANT CORRECTION: gdeq/ampeq below are now
        // gated to `is_full_tick` (SAMPLE_RATE_HZ), NOT called on every
        // fast tick the way the rest of this block still is. Found via
        // real-bench report: "I enabled the x4 interp in code... to get
        // higher Fs for w test but dont have the a+A in w test circuit?"
        // Root cause: envelope_gdeq_process()/envelope_ampeq_process()'s
        // coefficients (ssb_allpass1_t's `a`, the ampeq shelf biquads) are
        // fit assuming they run at SAMPLE_RATE_HZ - an IIR filter's real-
        // Hz response depends on normalized frequency (real Hz / the
        // ACTUAL rate it's clocked at), not just its coefficient. Calling
        // them every fast tick (ENVELOPE_INTERP_FACTOR x SAMPLE_RATE_HZ,
        // as this block did before this fix) silently runs them at
        // ENVELOPE_INTERP_FACTOR times their design rate. Quantified
        // (Fs=16000 vs Fs=64000, ENVELOPE_INTERP_FACTOR=4, the a+A
        // candidate's own coefficients): predicted 100-8000Hz p-p
        // dispersion collapses from ~72.6us (intended) to ~4.1us at 4x
        // the rate - gdeq would look like it does almost nothing on a
        // sweep; the default coefficients go from ~69.3us to ~1.2us,
        // even more collapsed. Same mechanism shifts the ampeq shelf
        // biquads' real corner frequency by that same factor, pushing
        // their boost mostly outside a 100-8000Hz sweep window. This
        // matches the reported symptom exactly, and explains it without
        // needing a+A to have been literally removed from the circuit -
        // its EFFECT just gets rate-warped down toward invisible.
        // Meanwhile the NORMAL production pipeline's own gdeq/ampeq calls
        // (envelope_gdeq_process()/envelope_ampeq_process() below, near
        // envelope_interp_on_full_tick()) were never affected by this -
        // they already only run on is_full_tick, i.e. genuinely at
        // SAMPLE_RATE_HZ regardless of ENVELOPE_INTERP_FACTOR's value,
        // because that gate decimates by exactly that same factor. Only
        // this early-intercept chirp path lacked the equivalent
        // decimation. Fix: gdeq/ampeq (and the DC mapping after them,
        // which is memoryless/rate-independent but kept alongside them
        // for the same call-once-per-full-tick reason) now run only on
        // is_full_tick, handing off to envelope_interp_on_full_tick()/
        // envelope_interp_on_interp_tick() - the SAME PWM-smoothing
        // machinery the normal pipeline already uses below - instead of
        // a direct envelope_output_write_pwm() call every fast tick. This
        // also means 'I' now controls the 'w' test's PWM smoothness the
        // same way it does for real playback, decoupled from gdeq/ampeq's
        // own fixed SAMPLE_RATE_HZ processing rate - the two concerns
        // this bug had conflated. The raw chirp waveform generation
        // (test_signals_generate_chirp() just below) is UNCHANGED - it
        // still runs every fast tick, so sweeping up to CHIRP_F1_HZ
        // (20kHz) is unaffected; only what gdeq/ampeq actually see is now
        // decimated to match their design rate. NOT yet bench-validated -
        // same not-yet-confirmed status as envelope_interp.h's own
        // interpolation feature.
        if (dsp_state_get_audio_source() == AUDIO_SRC_CHIRP) {
            // 2026-09-06 fix (see below): captured HERE, at the true top of
            // this tick, before test_signals_generate_chirp() or any of the
            // gdeq/ampeq/DC-mapping work below - envelope_interp.h's own
            // v4.1 note is explicit that a timestamp taken any later (e.g.
            // after this tick's own processing has already spent tens of
            // microseconds) makes compute_ramp_value()'s ramp timing wrong,
            // not just imprecise. Cheap (one register read) even on interp
            // ticks where it goes unused.
            int64_t chirp_tick_start_us = esp_timer_get_time();
            float chirp_envelope;
            bool ref_high;
            test_signals_generate_chirp(dsp_state_get_master_gain_linear(), &chirp_envelope, &ref_high);

            if (is_full_tick) {
                // Envelope-path group-delay equalizer - see envelope_gdeq.h.
                // Same call, same 'g' toggle, same live on/off behavior as
                // the normal full-tick pipeline's own envelope_gdeq_process()
                // call below (envelope_gdeq_process() internally no-ops when
                // disabled, so this is safe to call unconditionally here too
                // - no separate gating needed). Run BEFORE the predistort/
                // offset-scale mapping, matching that pipeline's own
                // ordering, so 'g' reshapes the swept envelope itself rather
                // than whatever the DC mapping already did to it. Gated to
                // is_full_tick - see this block's own top comment (2026-09-06
                // correction) for why.
                chirp_envelope = envelope_gdeq_process(chirp_envelope);

                // Envelope-path magnitude equalizer - see envelope_ampeq.h.
                // Same reasoning/wiring as gdeq just above, toggle 'a'
                // (shelf 1) / 'A' (shelf 2, added 2026-09-04, independent
                // flag) - this is what lets the chirp/TFA workflow measure
                // either shelf's actual on-bench correction directly via the
                // sweep's AMPLITUDE channel, the same way gdeq's phase
                // channel already validated its own refit.
                chirp_envelope = envelope_ampeq_process(chirp_envelope);

                // Apply the SAME offset/scale (or predistort) DC mapping
                // every other source gets from the normal full-tick pipeline
                // below - deliberately NOT skipped here, unlike
                // envelope_floor (see this block's own top comment for why
                // that one stays skipped). Master gain ('+'/'-', already
                // passed into test_signals_generate_chirp() above) only
                // scales the SWING around AM_TEST_DEPTH's fixed mean (same
                // convention as AMTEST) - it moves how HARD the filter is
                // driven, not WHERE on the duty range it's centered, so it
                // can't reveal a duty-range-dependent (DC-operating-point-
                // dependent) nonlinearity in the analog filter/BS170 gate
                // stage. 'u'/'j' (offset) and 'i'/'k' (scale) directly move
                // that operating point - exactly the knob needed to test the
                // TF across different parts of the duty range - so wiring
                // them in here is what actually answers that question, not
                // more gain.
                if (envelope_predistort_get_enabled()) {
                    chirp_envelope = envelope_predistort_process(chirp_envelope);
                } else {
                    chirp_envelope = chirp_envelope * envelope_output_get_pwm_scale() + envelope_output_get_pwm_offset();
                }
                // Final safety clamp - same bounds/reasoning as the normal
                // pipeline's own clamp right before its
                // envelope_interp_on_full_tick() call: an offset/scale
                // combination (or, at high master gain, AMTEST's own "swing
                // can push peaks past 1.0" case, still possible pre-mapping
                // above) can push this outside [0,1] - flatten it here
                // rather than wrapping the raw LEDC duty register.
                if (chirp_envelope < 0.0f) chirp_envelope = 0.0f;
                if (chirp_envelope > 1.0f) chirp_envelope = 1.0f;
                // Hand off to envelope_interp - same call the normal
                // pipeline uses below - instead of a direct
                // envelope_output_write_pwm(). Writes PWM for this full
                // tick, and (if 'I' is on) arms the ramp
                // envelope_interp_on_interp_tick() advances on the fast
                // ticks in between; if 'I' is off, on_interp_tick() does
                // nothing at all on those ticks (envelope_interp.cpp) and
                // the LEDC hardware simply holds this tick's duty value -
                // the same already-understood baseline ZOH behavior the
                // normal pipeline has always had. chirp_tick_start_us was
                // captured at the TOP of this tick, above - see that
                // comment for why it must not be taken here instead.
                envelope_interp_on_full_tick(chirp_envelope, chirp_tick_start_us);
            } else {
                envelope_interp_on_interp_tick();
            }
#if !CMD_DEBUG_PIN_ENABLED
            if (ref_high) {
                GPIO_FAST_SET(CHIRP_REF_GPIO);
            } else {
                GPIO_FAST_CLR(CHIRP_REF_GPIO);
            }
#endif
            continue;
        }

        if (!is_full_tick) {
            // Cheap path: no ADC read, no DSP compute, no AD9851/DAC/
            // diagnostics work - just one more step of envelope_interp's
            // ramp (a no-op when interpolation is disabled). Everything
            // below this block is the ORIGINAL per-tick body, unchanged,
            // now only reached on the 1-in-ENVELOPE_INTERP_FACTOR "full"
            // ticks.
            envelope_interp_on_interp_tick();
            continue;
        }

#if TIMING_DEBUG_ENABLED
        digitalWrite(TIMING_DEBUG_GPIO, HIGH);
#endif
        int64_t t_start_us = esp_timer_get_time();
#if DIAG_HOTPATH_RECORDING_ENABLED
        diagnostics_record_tick_start(t_start_us);
#endif

#if AD9851_ATTACHED && TX_WRITE_RESYNC_ENABLED
        // Re-sync write, FIRST thing this tick, before any of this tick's
        // own variable-duration DSP work below - see config.h's
        // TX_WRITE_RESYNC_ENABLED comment. Writes out LAST tick's already-
        // computed, already-delay-line-adjusted result, using THIS tick's
        // t_start_us as envelope_interp's own ramp timing reference (this
        // write is happening now, at this tick's start - see envelope_
        // interp.h's v4.1 note for why that timestamp matters).
        //
        // Envelope/PWM is always written here, task-side, regardless of
        // AD9851_ISR_WRITE_ENABLED - see on_timer_alarm()'s own comment for
        // why that leg deliberately never moves into the ISR. The AD9851
        // write only happens here when AD9851_ISR_WRITE_ENABLED is OFF -
        // when it's on, the ISR already committed this same buffered
        // frequency (via s_pending_tx_freq) just before waking this task,
        // so there's nothing left for dsp_task to do for that leg.
        if (s_pending_valid) {
            envelope_interp_on_full_tick(s_pending_envelope, t_start_us);
#if !AD9851_ISR_WRITE_ENABLED
            (void)carrier_output_set_freq_dev(s_pending_freq_dev_hz);
#endif
        }
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
void loop()
{
    // Core 1 breakdown - "what is Core 1 actually doing" (see the
    // [core1] idle% finding: both cores are essentially saturated, so
    // this answers where that time goes). Each call bracketed with
    // esp_timer_get_time(), summed into diagnostics.cpp's own
    // accumulators via one combined recorder call at the end - see
    // diagnostics_record_core1_loop_timings()'s header comment.
    int64_t t_cmd0 = esp_timer_get_time();
#if TIMING_DEBUG_ENABLED && CMD_DEBUG_PIN_ENABLED
    // See config.h's TIMING_DEBUG_GPIO_CMD comment - marks the exact
    // window handle_serial_commands() is running, to scope alongside
    // pin5 and test the "serial activity delays/disrupts gptimer's
    // alarm ISR" theory directly, rather than relying on manual timing.
    // Gated on CMD_DEBUG_PIN_ENABLED (config.h) - off by default now that
    // this same physical pin (39) is the chirp test mode's square-wave
    // reference output (CHIRP_REF_GPIO); the two must never toggle it at
    // once. Flip CMD_DEBUG_PIN_ENABLED back to 1 to re-enable this marker.
    digitalWrite(TIMING_DEBUG_GPIO_CMD, HIGH);
#endif
    handle_serial_commands();
#if TIMING_DEBUG_ENABLED && CMD_DEBUG_PIN_ENABLED
    digitalWrite(TIMING_DEBUG_GPIO_CMD, LOW);
#endif
    int64_t t_cmd1 = esp_timer_get_time();

    // Keep adc_continuous's internal pool from filling up - see
    // adc_capture.h. Low priority, not time-critical - fine to do here
    // alongside the other loop() work.
#if ADC_CAPTURE_ENABLED
    adc_capture_service();
#endif
    int64_t t_adcsvc1 = esp_timer_get_time();

    // Throttled status/timing/adc diagnostic prints - see diagnostics.h.
    // This task is lower priority than both real-time tasks, so it never
    // competes with either for CPU time or bus access.
    diagnostics_service();
    int64_t t_diag1 = esp_timer_get_time();

    // delay(10) below used to go completely unmeasured - it's loop()'s
    // ONLY remaining code after the three calls above, so at a 10ms
    // request it should be by far the biggest chunk of every iteration
    // (idle/blocked, nothing else needs Core 1). It was landing entirely
    // in the old "other" bucket instead - see diagnostics_record_
    // core1_loop_timings()'s header comment for what that turned out to
    // mean for the [core1] idle hook reading too.
    int64_t t_delay0 = t_diag1;
    delay(10);
    int64_t t_delay1 = esp_timer_get_time();

    diagnostics_record_core1_loop_timings((uint32_t)(t_cmd1 - t_cmd0),
                                           (uint32_t)(t_adcsvc1 - t_cmd1),
                                           (uint32_t)(t_diag1 - t_adcsvc1),
                                           (uint32_t)(t_delay1 - t_delay0));
}
