Rich5252/Arduino_ESP32_AD9851_ssb_signal_generator/(commit log)

2026-09-29 Add ADC audio filter plots
2026-09-29 Add PWM filter circuit
2026-09-30 Revamp of Interp and ISR writes to PWm & 9851. Also includes launching dsp task earlier to avoid missing next slot.
    [carrier_output.h, config.h, envelope_interp.cpp, envelope_interp.h, envelope_output.cpp, envelope_output.h, serial_commands.cpp, ssb_mic_test.ino]
2026-09-30 Good working version of 64kFs ISR interps and write to both 9851 & PWM.
    Closed-loop ISR interp staging and diagnostics
    Change ISR-interp staging from open-loop to closed-loop: task now reads the ISR accumulator (accum_now) and computes per-period stage as step = (target - accum_now) / FACTOR, retaining Bresenham carry only as informational. This prevents unbounded ISR accumulator drift from timing slips.
    Add staging-error monitoring and reset:
    - New ISR-interp stats (s_isr_interp_stage_err_*): last error, max abs error, event count (|e| > FACTOR-1), sample count, valid flag.
    - DSP writes stats; serial 'b' diagnostics print them; reseed clears valid; diagnostics_reset() now clears these sta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
    [diagnostics.cpp, diagnostics.h, envelope_output.cpp, envelope_output.h, serial_commands.cpp]
2026-09-30 Defines to go back to no 64k Interp and PWM write in dsp task
